sui001/homeostat/(commit log)

2026-11-03 Add redrawn homeostat unit schematic page
    Add a modern schematic, unit wiring and four-unit interconnect to the
    visualiser folder, and link its Pages URL from the README.
2026-11-04 Add coil sweep bench test for the wired mock-up arm
    ESP32-S3 Supermini drives a hard drive voice coil through an Adafruit Motor
    Shield v2.3 on M1: slow sweep, hold, knock, brake and release over serial.
    Flashed; not yet seen running on the arm.
2026-11-04 Add ToF identify sketch: tells a VL53L0X from a VL53L1X on the dual-footprint board
2026-11-04 Add arm hold test: VL53L0X position loop holds the HDD arm at a target
    Coil only pushes, so open loop the arm stuck then flicked to an end. This
    reads a flag on the arm, chases a target with a stiction kick and speed
    braking, and saves the ends and gains in flash. Flashed, shield and sensor
    found; not yet tuned on the arm.
2026-11-04 Add live ToF range page for lining up the sensor and arm flag
    tof_range_stream prints raw VL53L0X readings at ~50 Hz; range_view.py
    serves a local page with the live distance, jitter, a 10 s trace and an
    end A / end B check of travel against jitter.
2026-11-04 Range page: two-point ToF calibration against ruler distances, saved in the browser
2026-11-04 Add sweep-and-sense test; range page plots coil drive and logs CSV
    First run: arm sits at ~172 mm under negative drive and ~142 mm under
    positive, flipping near zero drive, so the ToF sees the full ~30 mm of
    travel clearly above its jitter.
2026-11-04 Add the bench build page and link it from the redrawn unit and README
    Records the 4 Nov build of the first needle: bench rig schematic, the HDD
    arm with its ToF, the logged sweep, why these parts, firmware and parts.
